sww1235/KiCAD-Libraries/Uncatagorized parts/_conversion_log.txt

#********** START OF eagle-lbr2kicad-1.0.ulp 1.8 07-02-2016 :21:52:34 LOG **********#
    Conversion completed with no Messages
#********** END OF eagle-lbr2kicad-1.0.ulp 1.8 07-02-2016 :21:52:34 LOG **********#
