sww1235/KiCAD-Libraries/SW-TEConn3dshapes/c-t4141012121-000-a-3d.stp

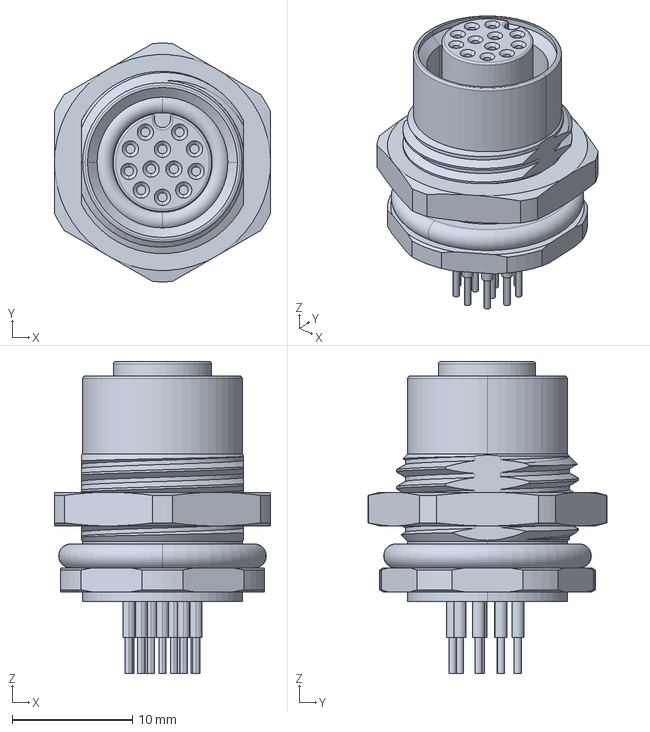
[picture p1: CAD file, 2019-04-18]
SW-TEConn3dshapes/c-t4141012121-000-a-3d.stp
18.0 x 19.9 x 26.0 mm
