sww1235/KiCAD-Libraries/(commit log)

2016-10-22 final adds and changes for schematic components
2016-10-30 adding more footprints
2016-10-30 adding 3 pin audio jack
2016-11-11 adding footprints
2016-12-01 added BMS parts
2017-02-02 Add amphenol connector footprints - Waterproof 4 pin circular connectors
2017-02-02 Add RPi GPIO header schematic part
2017-02-02 Add LED buck puck driver
2017-02-02 Added generic SPST relay schematic symbol
2017-03-26 Added Panasonic library
    - Added Lithium battery symbol
2017-03-26 Added Vishay library
    - dual diode package
2017-03-30 added thermistor and TVS to passives library
2017-03-30 Added USB-C controller to texas instruments lib + pcb BGA layout
2017-03-30 add dual mosfet and schottky diode - vishay
2017-03-30 modified pin locations of MAX1908
2017-03-30 added power mosfet
2017-03-30 add power mosfet IR
2017-03-30 consolidating raspberry pi headers library and adding compute module 3 layout
2017-03-30 adding ST ESD prot diodes
2017-03-30 removing old raspberry pi headers library
2017-04-07 Added USB type c connector
2017-04-07 Added a custom VBUS power symbol for USB type C
2017-04-08 Added 8x SPST switch
2017-04-08 Finally figured out power pin placement for SPST switch
2017-04-09 Added SPDT switch
2017-04-23 Swapped USB C 2.0 pin locations
2017-04-23 Added +20V power symbol
2017-04-23 Multiple Changes - Added N, 2xN and Ptype mosfets - Added USB Hub - Added ESD protection chip for USB C - Changed USB pin order on USB C Controller - Added I2C port multiplier
2017-04-24 Added power distro switch
2017-04-26 Added Neutrik EtherCon panelmount connector
2017-04-26 Changed pin name
2017-04-26 Added HDMI Connector and moved SD connector pinouts around
2017-04-26 Added HDMI ESD protection diodes
2017-04-26 Moved 5V power pin
2017-04-27 Added Diodes Inc library
2017-04-27 Added n channel mosfet
2017-05-01 Added dual power regulator
2017-05-04 Added another couple regulators
2017-05-04 Fixed missing pin number
2017-05-04 Added LM1084 regulator
2017-05-04 Added suntsu library and crystal footprint
2017-05-05 Removed empty and misfiled footprint
2017-05-05 Added Neutrik ethercon vertical footprint
    after lots of faffing about
2017-05-05 Added hinged microSD card holder
2017-05-05 Added footprints to transistors
2017-05-05 Added footprint to memory
2017-05-05 Added footprint files for texas transistors
2017-05-05 Added footprint file for winbond flash
2017-05-05 Added footprint for DMG1012T transistor
2017-05-05 Added footprint for ethernet magnetics
2017-05-05 Added footprints for both hdmi ESD protection diodes
2017-05-05 Added 17 resistor bussed network
2017-05-05 Added som-18 footprint for resistor network
2017-05-05 Fixing some pinout issues between schematic and footprint
2017-05-06 Changed footprints for USB C controller
2017-09-21 added digispark pcb layout and minipuck schematic/layout
2017-09-28 Changed power pins to avoid conflicts
2017-09-30 Added littelfuse footprint
2017-09-30 Added MCP73833 from microchip
    Li-Ion/Li-Po battery management IC
2017-09-30 Update pin positioning of microchip part
2017-10-01 Added e-switch tactile switch
2017-10-01 Add footprint outline and move pins
2017-10-01 Added molex high amperage pin connector footprints
2017-10-01 Added TEConn 2 row 8 position pin connector footprint
2017-10-01 Added SPST and SPDT switch symbols
2017-10-01 Update library for new kicad version
2017-10-01 Updated analog switch with additional description line
2017-10-01 Added nano fuse holder from littelfuse
2017-12-15 Added Analog Devices library
    - ADP5071
    - ADG715
    - ADG734
    - ADG708
2017-12-18 Added TVS diode
2017-12-26 Added op amps and new power symbols
2017-12-29 Updated symbol for 1 wire ESD protection diode
2018-01-02 Changed pin names on analog devices 708 to be zero indexed. no pinout changes
2018-01-06 Changed font size on power pin to be consistant with kicad defaults
2018-01-20 Changed schematic symbol pin layout on ADP5071
    so it made more sense with a typical parts layout
2018-01-20 Swapped pin locations of VREG so they make sense
2018-01-20 Added LM27762 charge pump dual output inverter regulator
2018-01-20 Added ICL7662 charge pump inverter
2018-01-20 Updated analog switch power connectors to be similar
2018-01-20 Changed pin length on ADG734 power port to be consistant with ADG715
2018-01-21 Added LMZ34002 voltage regulator to SW-Texas
2018-01-21 Added Arduino Nano
    - Schematic Symbol
    - Footprint
    - 3d model from grabcad
2018-01-22 Arduino lib "changed"
2018-01-22 Changed CE pin type on DS1882
2018-01-22 Changed pin type for second output pin on regulators to resolve conflicts
2018-01-22 Added footprint for 0582BQ (sot523)
2018-01-22 Added capacitor footprint for film capacitor
2018-01-23 Added footprints for ESD diode and power regulator
2018-01-23 Changed pin numbering on LM regulators to match up with SM footprint
2018-01-24 Added new capacitor footprint
2018-01-27 Added horizontal SOT-220-3 footprint with thermal pad
2018-02-21 Update the RKG footprint
    trying to get the custom shaped pad to connect to filled zones
2018-02-21 Added a bunch of Hirose DF11 footprints
2018-02-21 Added the 3d shapes for the footprints in the previous commit
2018-02-21 Added TO-220 vertical footprint for LM1084
2018-02-26 Added right angle df11 footprint and 3d model
2018-03-13 Fixed hirose footprint pinout mistakes
2018-03-23 Added spst mom switch with and without ground
2018-03-23 Added TL1105 right angle footprint and 3d model
2018-03-24 Added mounting hole locations for nano
2018-03-24 Added new footprint for gravitech ethernet-4nano
2018-03-25 update resistor network
2018-04-01 Added LTC3265
    dual inverting LDO regulator
2018-04-01 Added LM3880
    power supply sequencer
2018-04-03 Adding TSSOP-20 footprint with reduced exposed pad size for LTC3265
2018-04-05 Adding courtyard to footprint
2018-04-05 Adding courtyard to fuse footprint
2018-04-05 Adding 3d shape to semtech ESD diode
2018-10-15 Added 2 pole jst ph connectors and 3d models
2018-10-15 added a pad layout for pogo pin ISC programming
2018-10-15 Added 0.5A switching regulator module and i2c bus buffer / differential transmitter
2019-04-04 finished IO bank pin placement for cyclone 10
2019-04-04 Added FBGA484 footprint for intel FPGAs Using NSMD pads to increase routing space
2019-04-04 assigned cyclone 10 footprint
2019-04-07 Doc Weirdness, seems to be reverting datasheet fields.
    May need to revert or pull data out once kicad 6 is released. All
    datasheet management may change at this point anyways
2019-04-07 Changed invisible stacked power pins to passive type to avoid global net attachments.
2019-04-07 started on SAMD21J ARM Microprocessor symbol
2019-04-07 Finished SAMD21J microprocessors 2 variations for QFP or QFN w/ EP (has extra pin in symbol for EP)
2019-04-09 added +1V8A power symbol
2019-04-09 added MAX4910 4PDT switch
2019-04-12 changed pin location on wiznet W5500
2019-04-12 added Wima film capacitor footprint
2019-04-12 Added TI DSBGA-9 footprint
2019-04-18 Added footprint and 3D shape for CONEC X Coded M12 connector
2019-04-18 Added footprint and 3D shape for CUI Inc vertical usb b connector female
2019-04-18 Added 3D shapes and footprint for ADEC Q6 panel mount LED indicators
2019-04-18 Added 3D shape and footprint for TE Connectivity M12 female connector
    [c-t4141012121-000-a-3d.stp]
2019-04-18 added shielded usb b connector to replace the broken one in the default library
2019-04-18 Added Switchcraft through hole pcb mount DC power jack
2019-04-18 added 3D shape to switchcraft barrel jack
2019-04-18 added new switch
2019-04-19 Added intel switching power supplies
2019-04-21 Added 3 new ENPIRION power supplies and footprints
2019-04-21 Added CAT24C16 16Kb I2C EEPROM
2019-04-21 Added new barrel jack footprint
2019-04-21 Added TI switching regulator module and footprint
2019-04-21 fixed arrow width on custom power pins
2019-04-21 changed vneg pin to be passive electrical type
    since it is only ever connected to a filtering capactitor
2019-04-21 Added experimental horizontal footprint for RECOM R78B-2.0 regulator
    This needs an extra set of female right angle headers to work since the
    leads on the regulator itself are too short to be bent at a right angle
2019-04-22 Added footprint for Aluminium Polymer SMD Electrolytic Capacitor
2019-04-22 Added LM74610-Q1 ideal diode controller
2019-05-05 Added 3D model to APEM Q6 LED indicator
2019-05-05 Added Wurth Electronic Capacitor 3D models
2019-05-05 Added H1102NL 3d shape since the kicad libraries don't have it
2019-05-05 had to add a copy of the kicad footprint as well to apply the 3d model properly
2019-07-06 Added DD-78 Male and Female connector symbols
2019-07-10 Adding Harting footprints and 3d models for DD-78M and F connectors
2019-07-18 Added connector description to TEConn connector
2019-07-18 removed misplaced connector footprint
2019-07-18 Added DC-62 Dsub connectors and footprints for associated Harting connectors
2019-07-18 Added FSA2367 triple SPDT audio switch and unnecessary footprint
2019-07-23 Added custom JST-PHD connector from kicad stdlib and added 3D shape
2019-07-24 Added 3d models of generic SMD parts and copied 0402 diode footprint from kicad libraries
    so I could add the 3d model without breaking things
2019-08-18 forgot to add 3d model to footprint for Empirion regulator
2019-09-20 Added I2C flash memory chip
2020-03-04 Added new power symbol
2020-03-04 added audio jack with separate switch
2025-10-04 migrating schematic libraries to new file format for KiCAD 9
2025-10-04 Fix Bourne Encoder PCB Footprint mismatch with symbol
    Closes #1
2025-10-16 Initial add of Adafruit KB2040 board.
    Will need to revisit footprint eventually for mechanical clearances on
    the JST connector
2025-10-20 Added 5302_KB2040 files and updated footprint for SK65812
2025-11-03 modifying pads on SK6812 footprint
